AleksaHeler/OpenHand/hardware/OpenHand_v3/Datasheets/STM32_Pin_Assignment.xlsx

Pin # | Pin Name | GPIO | ADC | PWM | Misc | User Label | Notes
1 | VBAT |  |  |  | +3V3 | /
2 | PC13 |  |  |  | TAMPER-RTC |  | testpoint
3 | PC14 |  |  |  | OSC32_IN |  | testpoint
4 | PC15 |  |  |  | OSC32_OUT |  | testpoint
5 | PD0 |  |  |  | OSC_IN | XTAL_OSC_IN
6 | PD1 |  |  |  | OSC_OUT | XTAL_OSC_OUT
7 | NRST |  |  |  | NRST | RESET | NRST
8 | PC0 |  | ADC123_IN10 |  |  | EMG_01
9 | PC1 |  | ADC123_IN11 |  |  | EMG_02
10 | PC2 |  | ADC123_IN12 |  |  | TRIM_POT_01
11 | PC3 |  | ADC123_IN13 |  |  | TRIM_POT_02
12 | VSSA |  |  |  | GND | /
13 | VDDA |  |  |  | +3V3 | /
14 | PA0 |  | ADC123_IN0 | TIM2_CH1_ETR, TIM5_CH1, TIM8_ETR |  | MOTOR_03_ENCODER_A
15 | PA1 |  | ADC123_IN1 | TIM5_CH2, TIM2_CH2 |  | MOTOR_03_ENCODER_B
16 | PA2 |  | ADC123_IN2 | TIM5_CH3, TIM2_CH3 | USART2_TX |  | testpoint (ADC, TIM)
17 | PA3 |  | ADC123_IN3 | TIM5_CH4, TIM2_CH4 | USART2_RX |  | testpoint (ADC, TIM)
18 | VSS |  |  |  | GND | /
19 | VDD |  |  |  | +3V3 | /
20 | PA4 | OUTPUT | ADC12_IN4 |  |  | LED_01
21 | PA5 | OUTPUT | ADC12_IN5 |  | SPI1_SCK | LED_02
22 | PA6 |  | ADC12_IN6 | TIM8_BKIN, TIM3_CH1, TIM1_BKIN | SPI1_MISO | MOTOR_01_ENCODER_A
23 | PA7 |  | ADC12_IN7 | TIM8_CH1N, TIM3_CH2, TIM1_CH1N | SPI1_MOSI | MOTOR_01_ENCODER_B
24 | PC4 |  | ADC12_IN14 |  |  | PCB_TEMP_01
25 | PC5 |  | ADC12_IN15 |  |  | PCB_TEMP_02
26 | PB0 |  | ADC12_IN8 | TIM3_CH3, TIM8_CH2N, TIM1_CH2N |  | BATT_SENSE
27 | PB1 |  | ADC12_IN9 | TIM3_CH4, TIM8_CH3N, TIM1_CH3N |  | VIN_5V_SENSE
28 | PB2 | OUTPUT |  |  |  | MOTOR_01_EN
29 | PB10 | OUTPUT |  | TIM2_CH3 | I2C2_SCL, USART3_TX | MOTOR_02_EN
30 | PB11 | OUTPUT |  | TIM2_CH4 | I2C2_SDA, USART3_RX | MOTOR_03_EN
31 | VSS |  |  |  | GND | /
32 | VDD |  |  |  | +3V3 | /
33 | PB12 | OUTPUT |  | TIM1_BKIN |  | HAPTIC_DIR
34 | PB13 | OUTPUT |  | TIM1_CH1N | SPI2_SCK | MOTOR_01_DIR
35 | PB14 | OUTPUT |  | TIM1_CH2N | SPI2_MISO | MOTOR_02_DIR
36 | PB15 | OUTPUT |  | TIM1_CH3N | SPI2_MOSI | MOTOR_03_DIR
37 | PC6 |  |  | TIM8_CH1, TIM3_CH1 |  | HAPTIC_PWM
38 | PC7 |  |  | TIM8_CH2, TIM3_CH2 |  | MOTOR_01_PWM
39 | PC8 |  |  | TIM8_CH3, TIM3_CH3 |  | MOTOR_02_PWM
40 | PC9 |  |  | TIM8_CH4, TIM3_CH4 |  | MOTOR_03_PWM
41 | PA8 | INPUT |  | TIM1_CH1 |  | MOTOR_01_FAULT
42 | PA9 | INPUT |  | TIM1_CH2 | USART1_TX | MOTOR_02_FAULT
43 | PA10 | INPUT |  | TIM1_CH3 | USART1_RX | MOTOR_03_FAULT
44 | PA11 |  |  | TIM1_CH4 | USBDM, CAN_RX | USB-
45 | PA12 |  |  | TIM1_ETR | USBDP, CAN_TX | USB+
46 | PA13 |  |  |  | JTMS, SWDIO | SWDIO
47 | VSS |  |  |  | GND | /
48 | VDD |  |  |  | +3V3 | /
49 | PA14 |  |  |  | JTCK, SWCLK | SWCLK
50 | PA15 | INPUT |  | TIM2_CH1_ETR |  | BTN
51 | PC10 |  |  |  | UART4_TX | UART_TX
52 | PC11 |  |  |  | UART4_RX | UART_RX
53 | PC12 | OUTPUT |  |  | UART5_TX | HAPTIC_EN
54 | PD2 | INPUT |  | TIM3_ETR | UART5_RX | HAPTIC_FAULT
55 | PB3 |  |  | TIM2_CH2 | SPI3_SCK, SPI1_SCK |  | testpoint (SPI, TIM)
56 | PB4 |  |  | TIM3_CH1 | SPI3_MISO, SPI1_MISO |  | testpoint (SPI)
57 | PB5 |  |  | TIM3_CH2 | SPI3_MOSI, SPI1_MOSI |  | testpoint (SPI)
58 | PB6 |  |  | TIM4_CH1 | I2C1_SCL, USART1_TX | MOTOR_02_ENCODER_A
59 | PB7 |  |  | TIM4_CH2 | I2C1_SDA, USART1_RX | MOTOR_02_ENCODER_B
60 | PB2 |  |  |  | BOOT0 | BOOT | BOOT
61 | PB8 |  |  | TIM4_CH3 | I2C1_SCL | I2C_SCL
62 | PB9 |  |  | TIM4_CH4 | I2C1_SDA | I2C_SDA
63 | VSS |  |  |  | GND | /
64 | VDD |  |  |  | +3V3 | /
