AleksaHeler/OpenHand/hardware/OpenHand_v3/OpenHand_v3.kicad_pcb

## KiCad design hardware/OpenHand_v3/OpenHand_v3.kicad_pcb (2025-04-18)

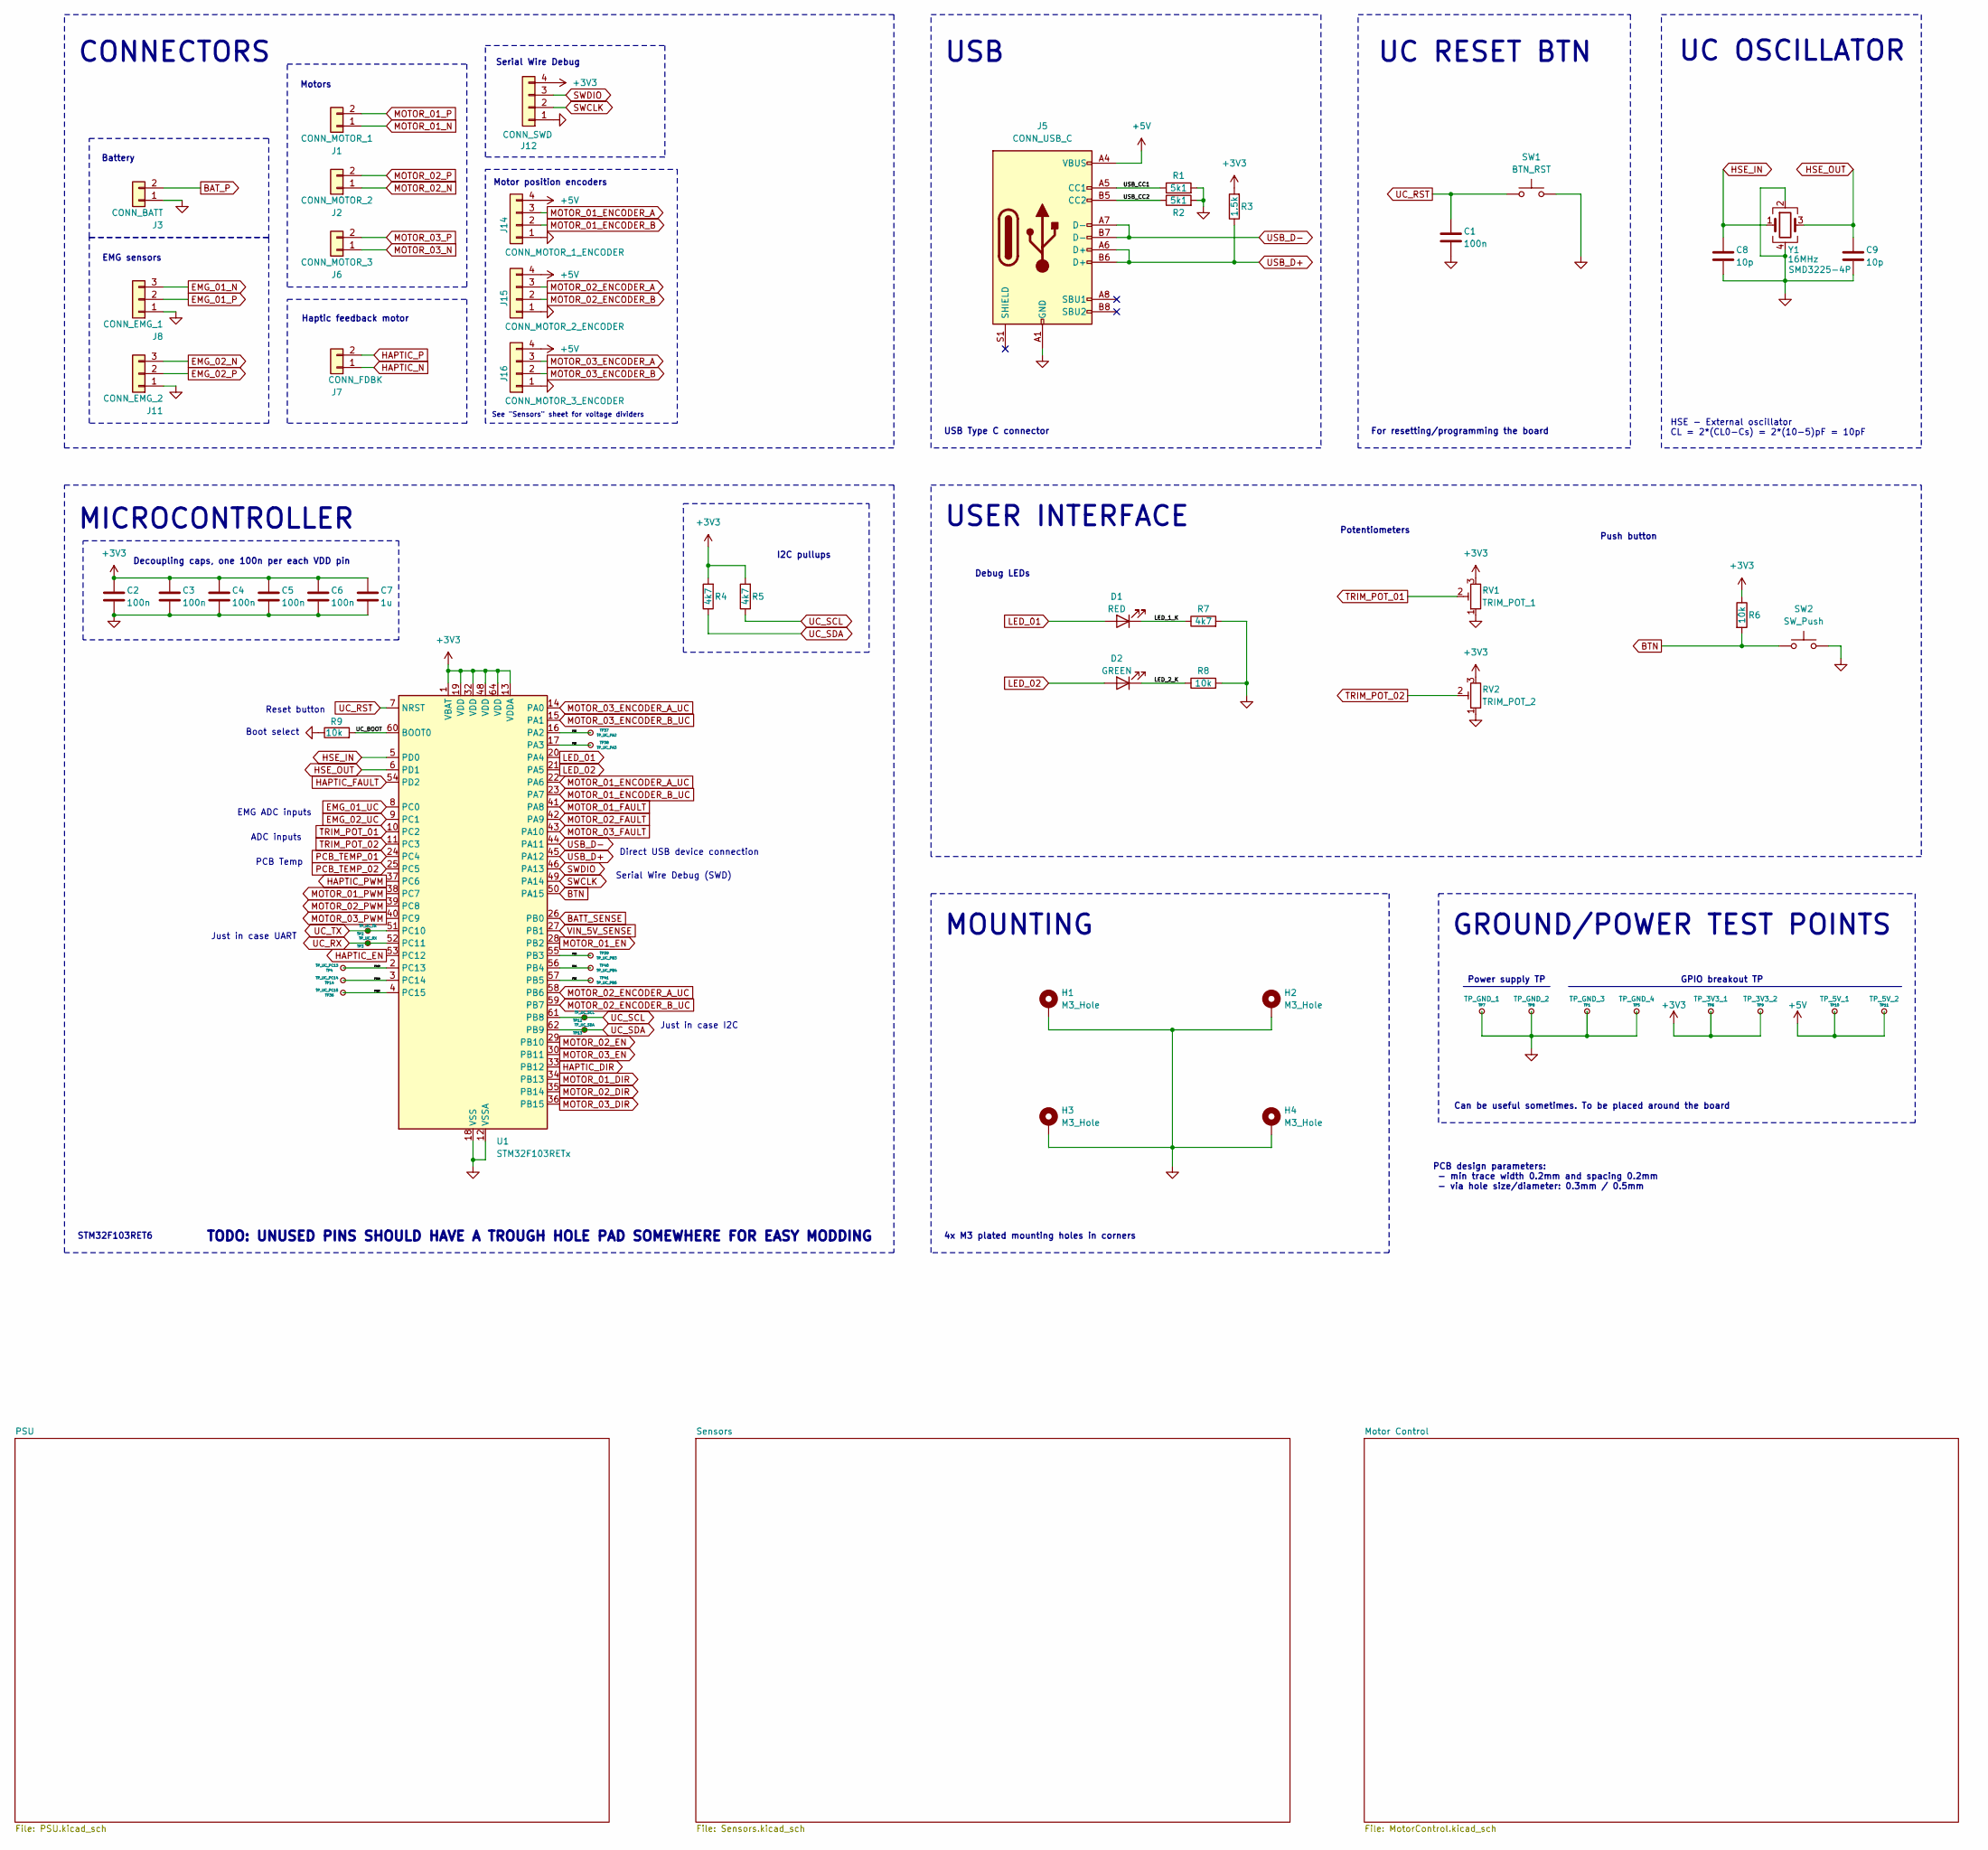
[picture p1: schematic OpenHand_v3.kicad_sch, OpenHand prosthetic hand controller project]

Parts:
C1, C2, C3, C4, C5, C6: 100n; C_0805_2012Metric
C7: 1u; C_0805_2012Metric
C8, C9: 10p; C_0805_2012Metric
D1: RED; LED_1210_3225Metric
D2: GREEN; LED_1210_3225Metric
H1, H2, H3, H4: M3_Hole; MountingHole_3.2mm_M3_Pad_Via
J1: CONN_MOTOR_1; JST_EH_S2B-EH_1x02_P2.50mm_Horizontal
J2: CONN_MOTOR_2; JST_EH_S2B-EH_1x02_P2.50mm_Horizontal
J3: CONN_BATT; JST_EH_S2B-EH_1x02_P2.50mm_Horizontal
J5: CONN_USB_C; USB_C_Receptacle_G-Switch_GT-USB-7010ASV
J6: CONN_MOTOR_3; JST_EH_S2B-EH_1x02_P2.50mm_Horizontal
J7: CONN_FDBK; JST_EH_S2B-EH_1x02_P2.50mm_Horizontal
J8: CONN_EMG_1; JST_XH_B3B-XH-A_1x03_P2.50mm_Vertical
J11: CONN_EMG_2; JST_XH_B3B-XH-A_1x03_P2.50mm_Vertical
J12: CONN_SWD; JST_XH_B4B-XH-A_1x04_P2.50mm_Vertical
J14: CONN_MOTOR_1_ENCODER; JST_XH_B4B-XH-A_1x04_P2.50mm_Vertical
J15: CONN_MOTOR_2_ENCODER; JST_XH_B4B-XH-A_1x04_P2.50mm_Vertical
J16: CONN_MOTOR_3_ENCODER; JST_XH_B4B-XH-A_1x04_P2.50mm_Vertical
R1, R2: 5k1; R_0805_2012Metric
R3: 1.5k; R_0805_2012Metric
R4, R5, R7: 4k7; R_0805_2012Metric
R6, R8, R9: 10k; R_0805_2012Metric
RV1: TRIM_POT_1; Potentiometer_Vishay_TS53YJ_Vertical
RV2: TRIM_POT_2; Potentiometer_Vishay_TS53YJ_Vertical
SW1: BTN_RST; SW_Tactile_SPST_NO_Straight_CK_PTS636Sx25SMTRLFS
SW2: SW_Push; SW_Tactile_SPST_NO_Straight_CK_PTS636Sx25SMTRLFS
TP1: TP_GND_3; TestPoint_THTPad_D1.5mm_Drill0.7mm
TP2: TP_UC_TX; TestPoint_THTPad_D1.5mm_Drill0.7mm
TP3: TP_UC_RX; TestPoint_THTPad_D1.5mm_Drill0.7mm
TP4: TP_UC_PC13; TestPoint_THTPad_D1.5mm_Drill0.7mm
TP5: TP_GND_4; TestPoint_THTPad_D1.5mm_Drill0.7mm
TP6: TP_3V3_1; TestPoint_THTPad_D1.5mm_Drill0.7mm
TP7: TP_GND_1; TestPoint_THTPad_D1.5mm_Drill0.7mm
TP8: TP_GND_2; TestPoint_THTPad_D1.5mm_Drill0.7mm
TP9: TP_3V3_2; TestPoint_THTPad_D1.5mm_Drill0.7mm
TP10: TP_5V_1; TestPoint_THTPad_D1.5mm_Drill0.7mm
TP11: TP_5V_2; TestPoint_THTPad_D1.5mm_Drill0.7mm
TP12: TP_UC_SCL; TestPoint_THTPad_D1.5mm_Drill0.7mm
TP13: TP_UC_SDA; TestPoint_THTPad_D1.5mm_Drill0.7mm
TP14: TP_UC_PC14; TestPoint_THTPad_D1.5mm_Drill0.7mm
TP36: TP_UC_PC15; TestPoint_THTPad_D1.5mm_Drill0.7mm
TP37: TP_UC_PA2; TestPoint_THTPad_D1.5mm_Drill0.7mm
TP38: TP_UC_PA3; TestPoint_THTPad_D1.5mm_Drill0.7mm
TP39: TP_UC_PB3; TestPoint_THTPad_D1.5mm_Drill0.7mm
TP40: TP_UC_PB4; TestPoint_THTPad_D1.5mm_Drill0.7mm
TP41: TP_UC_PB5; TestPoint_THTPad_D1.5mm_Drill0.7mm
U1: STM32F103RETx; LQFP-64_10x10mm_P0.5mm
Y1: 16MHz; Crystal_SMD_3225-4Pin_3.2x2.5mm

Connections:
+3V3: C2.1, C3.1, C4.1, C5.1, C6.1, C7.1, J12.4, R3.2, R4.2, R5.2, R6.1, RV1.3, RV2.3, TP6.1, TP9.1, U1.1 (VBAT), U1.13 (VDDA), U1.19 (VDD), U1.32 (VDD), U1.48 (VDD), U1.64 (VDD); also elsewhere on the board
+5V: J5.A4 (VBUS), J5.A9 (VBUS), J5.B4 (VBUS), J5.B9 (VBUS), J14.4, J15.4, J16.4, TP10.1, TP11.1; also elsewhere on the board
/LED_1_K: D1.1 (K), R7.1
/LED_2_K: D2.1 (K), R8.1
/PA2: TP37.1, U1.16 (PA2)
/PA3: TP38.1, U1.17 (PA3)
/PB3: TP39.1, U1.55 (PB3)
/PB4: TP40.1, U1.56 (PB4)
/PB5: TP41.1, U1.57 (PB5)
/PC13: TP4.1, U1.2 (PC13)
/PC14: TP14.1, U1.3 (PC14)
/PC15: TP36.1, U1.4 (PC15)
/UC_BOOT: R9.2, U1.60 (BOOT0)
/USB_CC1: J5.A5 (CC1), R1.1
/USB_CC2: J5.B5 (CC2), R2.1
BATT_SENSE: U1.26 (PB0); also elsewhere on the board
BAT_P: J3.2; also elsewhere on the board
BTN: R6.2, SW2.1, U1.50 (PA15)
EMG_01_N: J8.3; also elsewhere on the board
EMG_01_P: J8.2; also elsewhere on the board
EMG_01_UC: U1.8 (PC0); also elsewhere on the board
EMG_02_N: J11.3; also elsewhere on the board
EMG_02_P: J11.2; also elsewhere on the board
EMG_02_UC: U1.9 (PC1); also elsewhere on the board
GND: C1.2, C2.2, C3.2, C4.2, C5.2, C6.2, C7.2, C8.2, C9.2, H1.1, H2.1, H3.1, H4.1, J3.1, J5.A1 (GND), J5.A12 (GND), J5.B1 (GND), J5.B12 (GND), J8.1, J11.1, J12.1, J14.1, J15.1, J16.1, R1.2, R2.2, R7.2, R8.2, R9.1, RV1.1, RV2.1, SW1.2, SW2.2, TP1.1, TP5.1, TP7.1, TP8.1, U1.12 (VSSA), U1.18 (VSS), U1.31 (VSS), U1.47 (VSS), U1.63 (VSS), Y1.2, Y1.4; also elsewhere on the board
HAPTIC_DIR: U1.33 (PB12); also elsewhere on the board
HAPTIC_EN: U1.53 (PC12); also elsewhere on the board
HAPTIC_FAULT: U1.54 (PD2); also elsewhere on the board
HAPTIC_N: J7.1; also elsewhere on the board
HAPTIC_P: J7.2; also elsewhere on the board
HAPTIC_PWM: U1.37 (PC6); also elsewhere on the board
HSE_IN: C8.1, U1.5 (PD0), Y1.1
HSE_OUT: C9.1, U1.6 (PD1), Y1.3
LED_01: D1.2 (A), U1.20 (PA4)
LED_02: D2.2 (A), U1.21 (PA5)
MOTOR_01_DIR: U1.34 (PB13); also elsewhere on the board
MOTOR_01_EN: U1.28 (PB2); also elsewhere on the board
MOTOR_01_ENCODER_A: J14.3; also elsewhere on the board
MOTOR_01_ENCODER_A_UC: U1.22 (PA6); also elsewhere on the board
MOTOR_01_ENCODER_B: J14.2; also elsewhere on the board
MOTOR_01_ENCODER_B_UC: U1.23 (PA7); also elsewhere on the board
MOTOR_01_FAULT: U1.41 (PA8); also elsewhere on the board
MOTOR_01_N: J1.1; also elsewhere on the board
MOTOR_01_P: J1.2; also elsewhere on the board
MOTOR_01_PWM: U1.38 (PC7); also elsewhere on the board
MOTOR_02_DIR: U1.35 (PB14); also elsewhere on the board
MOTOR_02_EN: U1.29 (PB10); also elsewhere on the board
MOTOR_02_ENCODER_A: J15.3; also elsewhere on the board
MOTOR_02_ENCODER_A_UC: U1.58 (PB6); also elsewhere on the board
MOTOR_02_ENCODER_B: J15.2; also elsewhere on the board
MOTOR_02_ENCODER_B_UC: U1.59 (PB7); also elsewhere on the board
MOTOR_02_FAULT: U1.42 (PA9); also elsewhere on the board
MOTOR_02_N: J2.1; also elsewhere on the board
MOTOR_02_P: J2.2; also elsewhere on the board
MOTOR_02_PWM: U1.39 (PC8); also elsewhere on the board
MOTOR_03_DIR: U1.36 (PB15); also elsewhere on the board
MOTOR_03_EN: U1.30 (PB11); also elsewhere on the board
MOTOR_03_ENCODER_A: J16.3; also elsewhere on the board
MOTOR_03_ENCODER_A_UC: U1.14 (PA0); also elsewhere on the board
MOTOR_03_ENCODER_B: J16.2; also elsewhere on the board
MOTOR_03_ENCODER_B_UC: U1.15 (PA1); also elsewhere on the board
MOTOR_03_FAULT: U1.43 (PA10); also elsewhere on the board
MOTOR_03_N: J6.1; also elsewhere on the board
MOTOR_03_P: J6.2; also elsewhere on the board
MOTOR_03_PWM: U1.40 (PC9); also elsewhere on the board
PCB_TEMP_01: U1.24 (PC4); also elsewhere on the board
PCB_TEMP_02: U1.25 (PC5); also elsewhere on the board
SWCLK: J12.2, U1.49 (PA14)
SWDIO: J12.3, U1.46 (PA13)
TRIM_POT_01: RV1.2, U1.10 (PC2)
TRIM_POT_02: RV2.2, U1.11 (PC3)
UC_RST: C1.1, SW1.1, U1.7 (NRST)
UC_RX: TP3.1, U1.52 (PC11)
UC_SCL: R5.1, TP12.1, U1.61 (PB8)
UC_SDA: R4.1, TP13.1, U1.62 (PB9)
UC_TX: TP2.1, U1.51 (PC10)
USB_D+: J5.A6 (D+), J5.B6 (D+), R3.1, U1.45 (PA12)
USB_D-: J5.A7 (D-), J5.B7 (D-), U1.44 (PA11)
VIN_5V_SENSE: U1.27 (PB1); also elsewhere on the board

Notes on the sheet:
I2C pullups
Debug LEDs
UC RESET BTN
Potentiometers
ADC inputs
Serial Wire Debug (SWD)
MICROCONTROLLER
Battery
PCB Temp
Haptic feedback motor
Reset button
Just in case I2C
USB
Push button
4x M3 plated mounting holes in corners
TODO: UNUSED PINS SHOULD HAVE A TROUGH HOLE PAD SOMEWHERE FOR EASY MODDING
Power supply TP
Motors
MOUNTING
CONNECTORS
PCB design parameters: - min trace width 0.2mm and spacing 0.2mm - via hole size/diameter: 0.3mm / 0.5mm
EMG ADC inputs
For resetting/programming the board
Can be useful sometimes. To be placed around the board
USB Type C connector
Decoupling caps, one 100n per each VDD pin
USER INTERFACE
STM32F103RET6
GROUND/POWER TEST POINTS
Boot select
GPIO breakout TP
EMG sensors
Direct USB device connection
HSE - External oscillator CL = 2*(CL0-Cs) = 2*(10-5)pF = 10pF
See "Sensors" sheet for voltage dividers
UC OSCILLATOR
Just in case UART
Serial Wire Debug
Motor position encoders

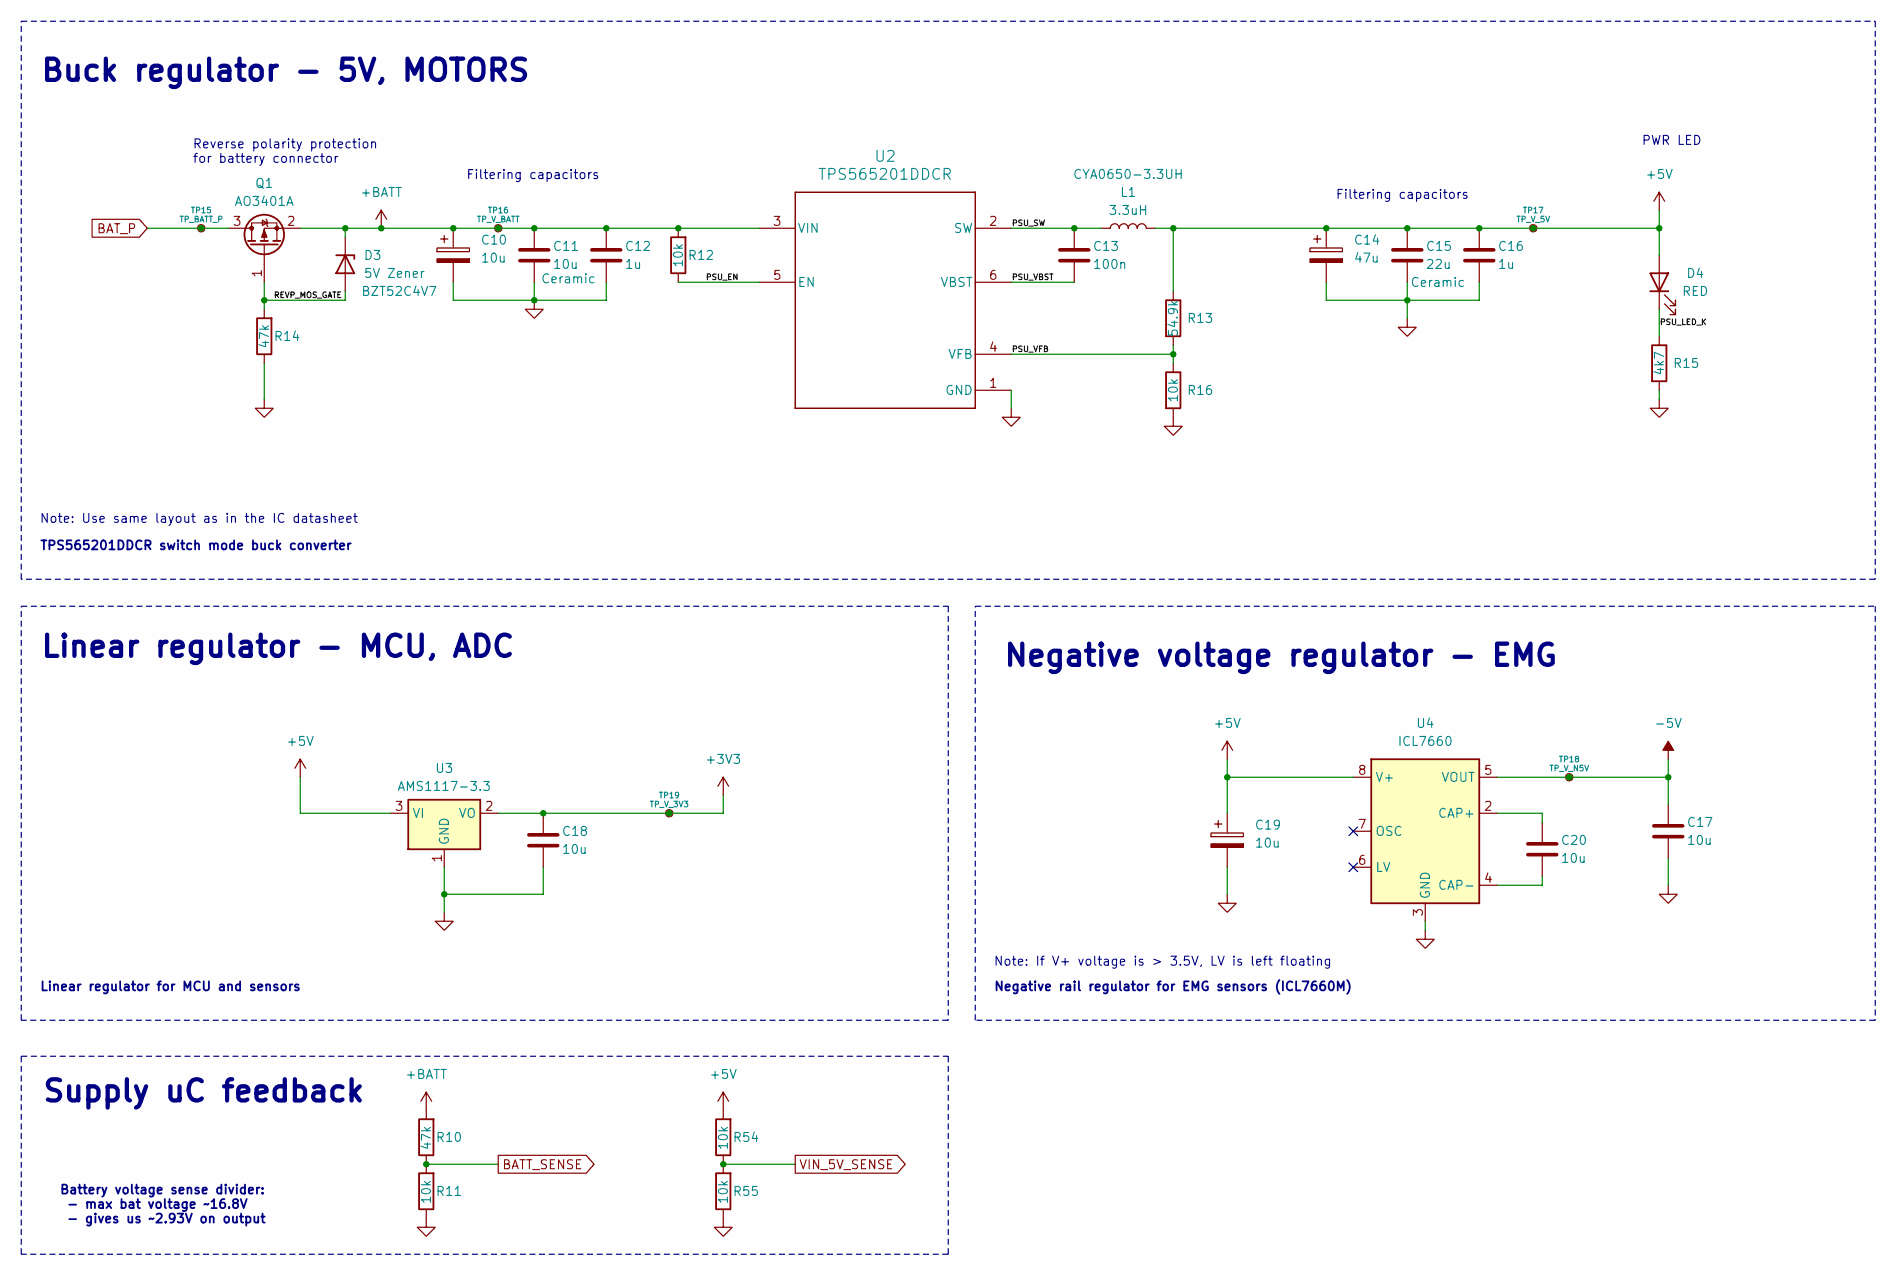
[picture p2: schematic PSU.kicad_sch, OpenHand prosthetic hand controller project]

Parts:
C10, C19: 10u; CP_Elec_4x5.4
C11, C17, C18, C20: 10u; C_0805_2012Metric
C12, C16: 1u; C_0805_2012Metric
C13: 100n; C_0805_2012Metric
C14: 47u; CP_Elec_6.3x5.4
C15: 22u; C_0805_2012Metric
D3: 5V Zener; D_SOD-123; Part Number BZT52C4V7
D4: RED; LED_1210_3225Metric
L1: 3.3uH; L_Bourns_SRP7028A_7.3x6.6mm; Part Number CYA0650-3.3UH
Q1: AO3401A; SOT-23
R10, R14: 47k; R_0805_2012Metric
R11, R12, R16, R54, R55: 10k; R_0805_2012Metric
R13: 54.9k; R_0805_2012Metric
R15: 4k7; R_0805_2012Metric
TP15: TP_BATT_P; TestPoint_Pad_D1.0mm
TP16: TP_V_BATT; TestPoint_Pad_D1.0mm
TP17: TP_V_5V; TestPoint_THTPad_D1.5mm_Drill0.7mm
TP18: TP_V_N5V; TestPoint_THTPad_D1.5mm_Drill0.7mm
TP19: TP_V_3V3; TestPoint_THTPad_D1.5mm_Drill0.7mm
U2: TPS565201DDCR; TPS565201DDCR_L
U3: AMS1117-3.3; SOT-223-3_TabPin2
U4: ICL7660; SOP-8_3.9x4.9mm_P1.27mm

Connections:
+3V3: C18.1, TP19.1, U3.2 (VO); also elsewhere on the board
+5V: C14.1, C15.1, C16.1, C19.1, D4.2 (A), L1.2, R13.1, R54.2, TP17.1, U3.3 (VI), U4.8 (V+); also elsewhere on the board
+BATT: C10.1, C11.1, C12.1, D3.1 (K), Q1.2 (S), R10.2, R12.2, TP16.1, U2.3 (VIN)
-5V: C17.1, TP18.1, U4.5 (VOUT); also elsewhere on the board
/PSU/PSU_EN: R12.1, U2.5 (EN)
/PSU/PSU_LED_K: D4.1 (K), R15.1
/PSU/PSU_SW: C13.1, L1.1, U2.2 (SW)
/PSU/PSU_VBST: C13.2, U2.6 (VBST)
/PSU/PSU_VFB: R13.2, R16.1, U2.4 (VFB)
/PSU/REVP_MOS_GATE: D3.2 (A), Q1.1 (G), R14.2
BATT_SENSE: R10.1, R11.2; also elsewhere on the board
BAT_P: Q1.3 (D), TP15.1; also elsewhere on the board
GND: C10.2, C11.2, C12.2, C14.2, C15.2, C16.2, C17.2, C18.2, C19.2, R11.1, R14.1, R15.2, R16.2, R55.1, U2.1 (GND), U3.1 (GND), U4.3 (GND); also elsewhere on the board
unnamed: C20.1, U4.2 (CAP+)
unnamed: C20.2, U4.4 (CAP-)
VIN_5V_SENSE: R54.1, R55.2; also elsewhere on the board

Notes on the sheet:
Linear regulator - MCU, ADC
Note: Use same layout as in the IC datasheet
Filtering capacitors
Supply uC feedback
PWR LED
Note: If V+ voltage is > 3.5V, LV is left floating
Negative voltage regulator - EMG
Buck regulator - 5V, MOTORS
TPS565201DDCR switch mode buck converter
Battery voltage sense divider: - max bat voltage ~16.8V - gives us ~2.93V on output
Negative rail regulator for EMG sensors (ICL7660M)
Linear regulator for MCU and sensors
Reverse polarity protection for battery connector

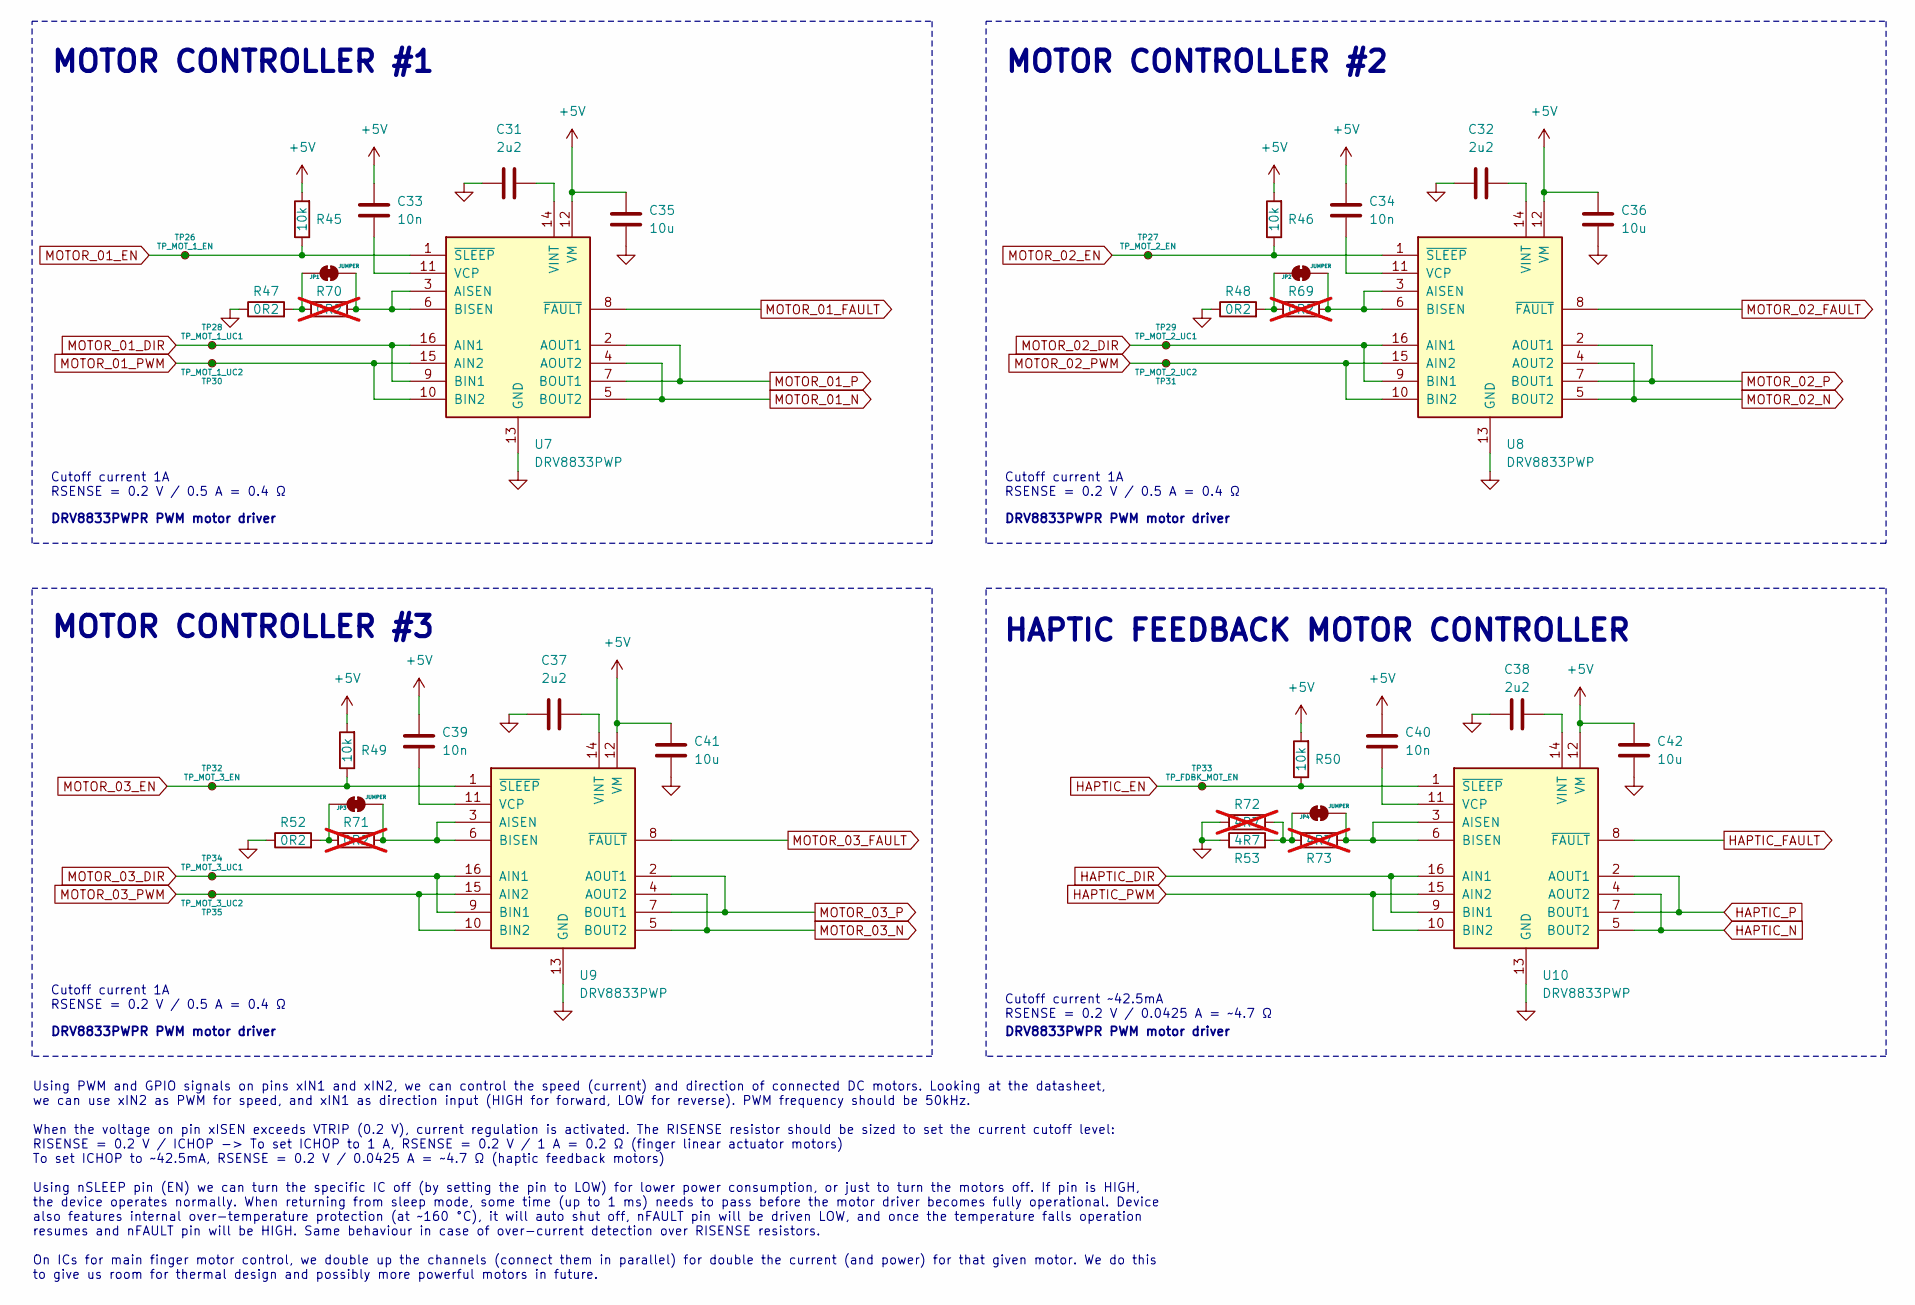
[picture p3: schematic MotorControl.kicad_sch, OpenHand prosthetic hand controller project]

Parts:
C31, C32, C37, C38: 2u2; C_0805_2012Metric
C33, C34, C39, C40: 10n; C_0805_2012Metric
C35, C36, C41, C42: 10u; C_0805_2012Metric
JP1, JP2, JP3, JP4: JUMPER; SolderJumper-2_P1.3mm_Bridged_RoundedPad1.0x1.5mm
R45, R46, R49, R50: 10k; R_0805_2012Metric
R47, R48, R52: 0R2; R_1206_3216Metric
R53: 4R7; R_1206_3216Metric
R69, R70, R71: 0R2; R_1206_3216Metric; not fitted
R72, R73: 4R7; R_1206_3216Metric; not fitted
TP26: TP_MOT_1_EN; TestPoint_Pad_D1.0mm
TP27: TP_MOT_2_EN; TestPoint_Pad_D1.0mm
TP28: TP_MOT_1_UC1; TestPoint_Pad_D1.0mm
TP29: TP_MOT_2_UC1; TestPoint_Pad_D1.0mm
TP30: TP_MOT_1_UC2; TestPoint_Pad_D1.0mm
TP31: TP_MOT_2_UC2; TestPoint_Pad_D1.0mm
TP32: TP_MOT_3_EN; TestPoint_Pad_D1.0mm
TP33: TP_FDBK_MOT_EN; TestPoint_Pad_D1.0mm
TP34: TP_MOT_3_UC1; TestPoint_Pad_D1.0mm
TP35: TP_MOT_3_UC2; TestPoint_Pad_D1.0mm
U7, U8, U9, U10: DRV8833PWP; HTSSOP-16-1EP_4.4x5mm_P0.65mm_EP3.4x5mm_Mask2.46x2.31mm_The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

Connections:
+5V: C33.1, C34.1, C35.1, C36.1, C39.1, C40.1, C41.1, C42.1, R45.2, R46.2, R49.2, R50.2, U7.12 (VM), U8.12 (VM), U9.12 (VM), U10.12 (VM); also elsewhere on the board
GND: C31.1, C32.1, C35.2, C36.2, C37.1, C38.1, C41.2, C42.2, R47.1, R48.1, R52.1, R53.1, R72.2, U7.13 (GND), U7.17 (GND), U8.13 (GND), U8.17 (GND), U9.13 (GND), U9.17 (GND), U10.13 (GND), U10.17 (GND); also elsewhere on the board
HAPTIC_DIR: U10.9 (BIN1), U10.16 (AIN1); also elsewhere on the board
HAPTIC_EN: R50.1, TP33.1, U10.1 (~SLEEP); also elsewhere on the board
HAPTIC_FAULT: U10.8 (~FAULT); also elsewhere on the board
HAPTIC_N: U10.4 (AOUT2), U10.5 (BOUT2); also elsewhere on the board
HAPTIC_P: U10.2 (AOUT1), U10.7 (BOUT1); also elsewhere on the board
HAPTIC_PWM: U10.10 (BIN2), U10.15 (AIN2); also elsewhere on the board
MOTOR_01_DIR: TP28.1, U7.9 (BIN1), U7.16 (AIN1); also elsewhere on the board
MOTOR_01_EN: R45.1, TP26.1, U7.1 (~SLEEP); also elsewhere on the board
MOTOR_01_FAULT: U7.8 (~FAULT); also elsewhere on the board
MOTOR_01_N: U7.4 (AOUT2), U7.5 (BOUT2); also elsewhere on the board
MOTOR_01_P: U7.2 (AOUT1), U7.7 (BOUT1); also elsewhere on the board
MOTOR_01_PWM: TP30.1, U7.10 (BIN2), U7.15 (AIN2); also elsewhere on the board
MOTOR_02_DIR: TP29.1, U8.9 (BIN1), U8.16 (AIN1); also elsewhere on the board
MOTOR_02_EN: R46.1, TP27.1, U8.1 (~SLEEP); also elsewhere on the board
MOTOR_02_FAULT: U8.8 (~FAULT); also elsewhere on the board
MOTOR_02_N: U8.4 (AOUT2), U8.5 (BOUT2); also elsewhere on the board
MOTOR_02_P: U8.2 (AOUT1), U8.7 (BOUT1); also elsewhere on the board
MOTOR_02_PWM: TP31.1, U8.10 (BIN2), U8.15 (AIN2); also elsewhere on the board
MOTOR_03_DIR: TP34.1, U9.9 (BIN1), U9.16 (AIN1); also elsewhere on the board
MOTOR_03_EN: R49.1, TP32.1, U9.1 (~SLEEP); also elsewhere on the board
MOTOR_03_FAULT: U9.8 (~FAULT); also elsewhere on the board
MOTOR_03_N: U9.4 (AOUT2), U9.5 (BOUT2); also elsewhere on the board
MOTOR_03_P: U9.2 (AOUT1), U9.7 (BOUT1); also elsewhere on the board
MOTOR_03_PWM: TP35.1, U9.10 (BIN2), U9.15 (AIN2); also elsewhere on the board
unnamed: JP1.1 (A), R47.2, R70.1
unnamed: JP1.2 (B), R70.2, U7.3 (AISEN), U7.6 (BISEN)
unnamed: JP2.1 (A), R48.2, R69.1
unnamed: JP2.2 (B), R69.2, U8.3 (AISEN), U8.6 (BISEN)
unnamed: JP3.1 (A), R52.2, R71.1
unnamed: JP3.2 (B), R71.2, U9.3 (AISEN), U9.6 (BISEN)
unnamed: JP4.1 (A), R53.2, R72.1, R73.1
unnamed: JP4.2 (B), R73.2, U10.3 (AISEN), U10.6 (BISEN)
unnamed: C33.2, U7.11 (VCP)
unnamed: C31.2, U7.14 (VINT)
unnamed: C34.2, U8.11 (VCP)
unnamed: C32.2, U8.14 (VINT)
unnamed: C39.2, U9.11 (VCP)
unnamed: C37.2, U9.14 (VINT)
unnamed: C40.2, U10.11 (VCP)
unnamed: C38.2, U10.14 (VINT)

Notes on the sheet:
Cutoff current 1A RSENSE = 0.2 V / 0.5 A = 0.4 Ω
MOTOR CONTROLLER #1
DRV8833PWPR PWM motor driver
HAPTIC FEEDBACK MOTOR CONTROLLER
Using PWM and GPIO signals on pins xIN1 and xIN2, we can control the speed (current) and direction of connected DC motors. Looking at the datasheet, we can use xIN2 as PWM for speed, and xIN1 as direction input (HIGH for forward, LOW for reverse). PWM frequency should be 50kHz. When the voltage on 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
MOTOR CONTROLLER #3
MOTOR CONTROLLER #2
Cutoff current ~42.5mA RSENSE = 0.2 V / 0.0425 A = ~4.7 Ω
Cutoff current 1A RSENSE = 0.2 V / 0.5 A = 0.4 Ω

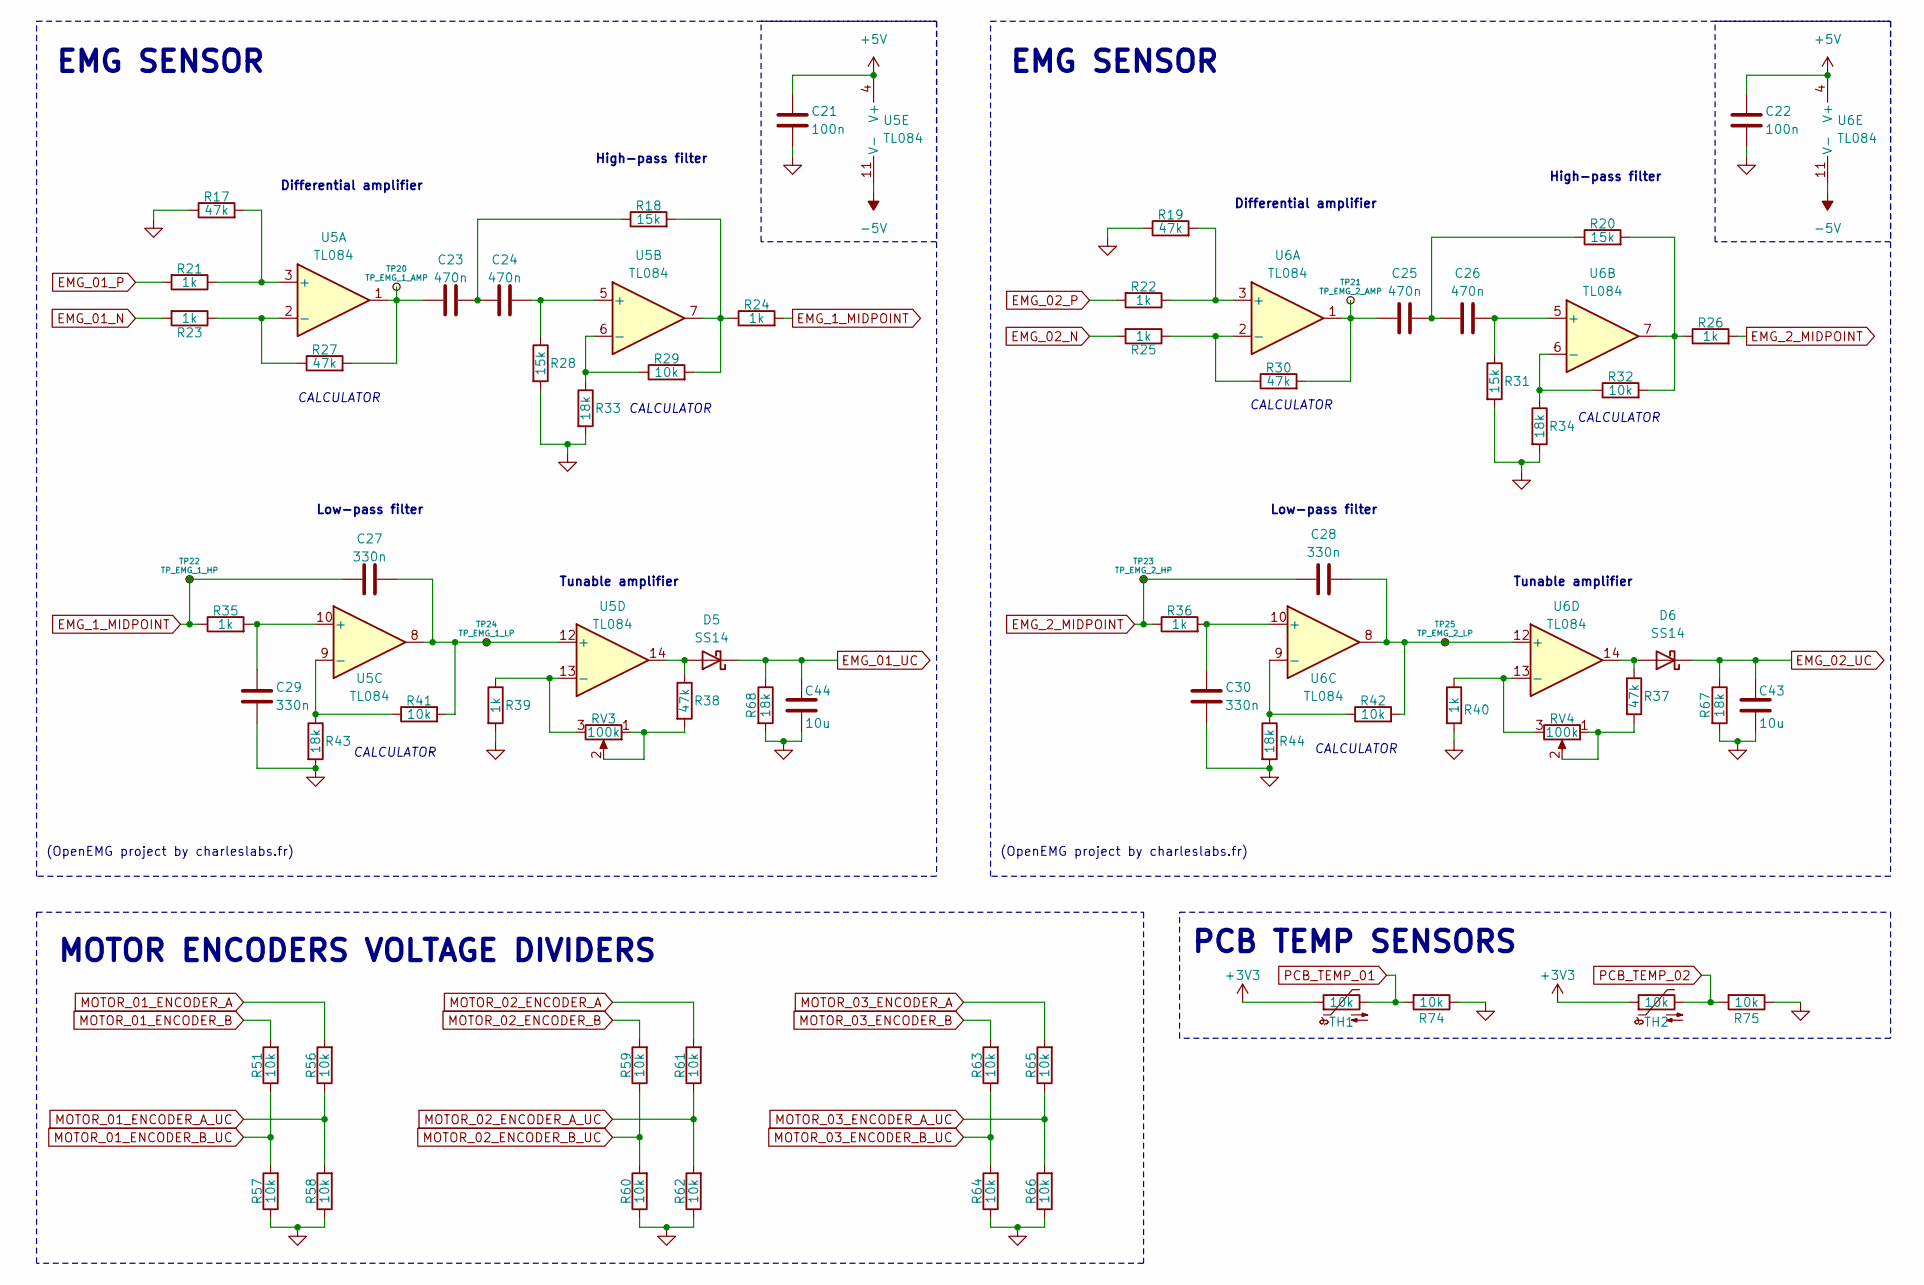
[picture p4: schematic Sensors.kicad_sch, OpenHand prosthetic hand controller project]

Parts:
C21, C22: 100n; C_0805_2012Metric
C23, C24, C25, C26: 470n; C_0805_2012Metric
C27, C28, C29, C30: 330n; C_0805_2012Metric
C43, C44: 10u; C_0805_2012Metric
D5, D6: SS14; D_SOD-123
R17, R19, R27, R30, R37, R38: 47k; R_0805_2012Metric
R18, R20, R28, R31: 15k; R_0805_2012Metric
R21, R22, R23, R24, R25, R26, R35, R36, R39, R40: 1k; R_0805_2012Metric
R29, R32, R41, R42, R51, R56, R57, R58, R59, R60, R61, R62, R63, R64, R65, R66, R74, R75: 10k; R_0805_2012Metric
R33, R34, R43, R44, R67, R68: 18k; R_0805_2012Metric
RV3, RV4: 100k; Potentiometer_Vishay_TS53YJ_Vertical
TH1, TH2: 10k; R_0805_2012Metric
TP20: TP_EMG_1_AMP; TestPoint_Pad_D1.0mm
TP21: TP_EMG_2_AMP; TestPoint_Pad_D1.0mm
TP22: TP_EMG_1_HP; TestPoint_Pad_D1.0mm
TP23: TP_EMG_2_HP; TestPoint_Pad_D1.0mm
TP24: TP_EMG_1_LP; TestPoint_Pad_D1.0mm
TP25: TP_EMG_2_LP; TestPoint_Pad_D1.0mm
U5, U6: TL084; SO-14_5.3x10.2mm_P1.27mm

Connections:
+3V3: TH1.1, TH2.1; also elsewhere on the board
+5V: C21.1, C22.1, U5.4 (V+), U6.4 (V+); also elsewhere on the board
-5V: U5.11 (V-), U6.11 (V-); also elsewhere on the board
EMG_1_MIDPOINT: C27.1, R24.2, R35.1, TP22.1
EMG_01_N: R23.2; also elsewhere on the board
EMG_01_P: R21.2; also elsewhere on the board
EMG_01_UC: C44.1, D5.1 (K), R68.1; also elsewhere on the board
EMG_2_MIDPOINT: C28.1, R26.2, R36.1, TP23.1
EMG_02_N: R25.2; also elsewhere on the board
EMG_02_P: R22.2; also elsewhere on the board
EMG_02_UC: C43.1, D6.1 (K), R67.1; also elsewhere on the board
GND: C21.2, C22.2, C29.1, C30.1, C43.2, C44.2, R17.1, R19.1, R28.2, R31.2, R33.2, R34.2, R39.2, R40.2, R43.2, R44.2, R57.1, R58.1, R60.1, R62.1, R64.1, R66.1, R67.2, R68.2, R74.1, R75.1; also elsewhere on the board
MOTOR_01_ENCODER_A: R56.2; also elsewhere on the board
MOTOR_01_ENCODER_A_UC: R56.1, R58.2; also elsewhere on the board
MOTOR_01_ENCODER_B: R51.2; also elsewhere on the board
MOTOR_01_ENCODER_B_UC: R51.1, R57.2; also elsewhere on the board
MOTOR_02_ENCODER_A: R61.2; also elsewhere on the board
MOTOR_02_ENCODER_A_UC: R61.1, R62.2; also elsewhere on the board
MOTOR_02_ENCODER_B: R59.2; also elsewhere on the board
MOTOR_02_ENCODER_B_UC: R59.1, R60.2; also elsewhere on the board
MOTOR_03_ENCODER_A: R65.2; also elsewhere on the board
MOTOR_03_ENCODER_A_UC: R65.1, R66.2; also elsewhere on the board
MOTOR_03_ENCODER_B: R63.2; also elsewhere on the board
MOTOR_03_ENCODER_B_UC: R63.1, R64.2; also elsewhere on the board
unnamed: C23.1, R27.2, TP20.1, U5.1
unnamed: C23.2, C24.1, R18.1
unnamed: C25.1, R30.2, TP21.1, U6.1
unnamed: C25.2, C26.1, R20.1
unnamed: D5.2 (A), R38.1, U5.14
unnamed: D6.2 (A), R37.1, U6.14
unnamed: R18.2, R24.1, R29.2, U5.7
unnamed: R20.2, R26.1, R32.2, U6.7
unnamed: R37.2, RV4.1, RV4.2
unnamed: R38.2, RV3.1, RV3.2
unnamed: R17.2, R21.1, U5.3 (+)
unnamed: R23.1, R27.1, U5.2 (-)
unnamed: C24.2, R28.1, U5.5 (+)
unnamed: R29.1, R33.1, U5.6 (-)
unnamed: C29.2, R35.2, U5.10 (+)
unnamed: R41.1, R43.1, U5.9 (-)
unnamed: C27.2, R41.2, TP24.1, U5.8, U5.12 (+)
unnamed: R39.1, RV3.3, U5.13 (-)
unnamed: R19.2, R22.1, U6.3 (+)
unnamed: R25.1, R30.1, U6.2 (-)
unnamed: C26.2, R31.1, U6.5 (+)
unnamed: R32.1, R34.1, U6.6 (-)
unnamed: C30.2, R36.2, U6.10 (+)
unnamed: R42.1, R44.1, U6.9 (-)
unnamed: C28.2, R42.2, TP25.1, U6.8, U6.12 (+)
unnamed: R40.1, RV4.3, U6.13 (-)
PCB_TEMP_01: R74.2, TH1.2; also elsewhere on the board
PCB_TEMP_02: R75.2, TH2.2; also elsewhere on the board

Notes on the sheet:
EMG SENSOR
MOTOR ENCODERS VOLTAGE DIVIDERS
Low-pass filter
CALCULATOR
PCB TEMP SENSORS
Differential amplifier
(OpenEMG project by charleslabs.fr)
High-pass filter
Tunable amplifier

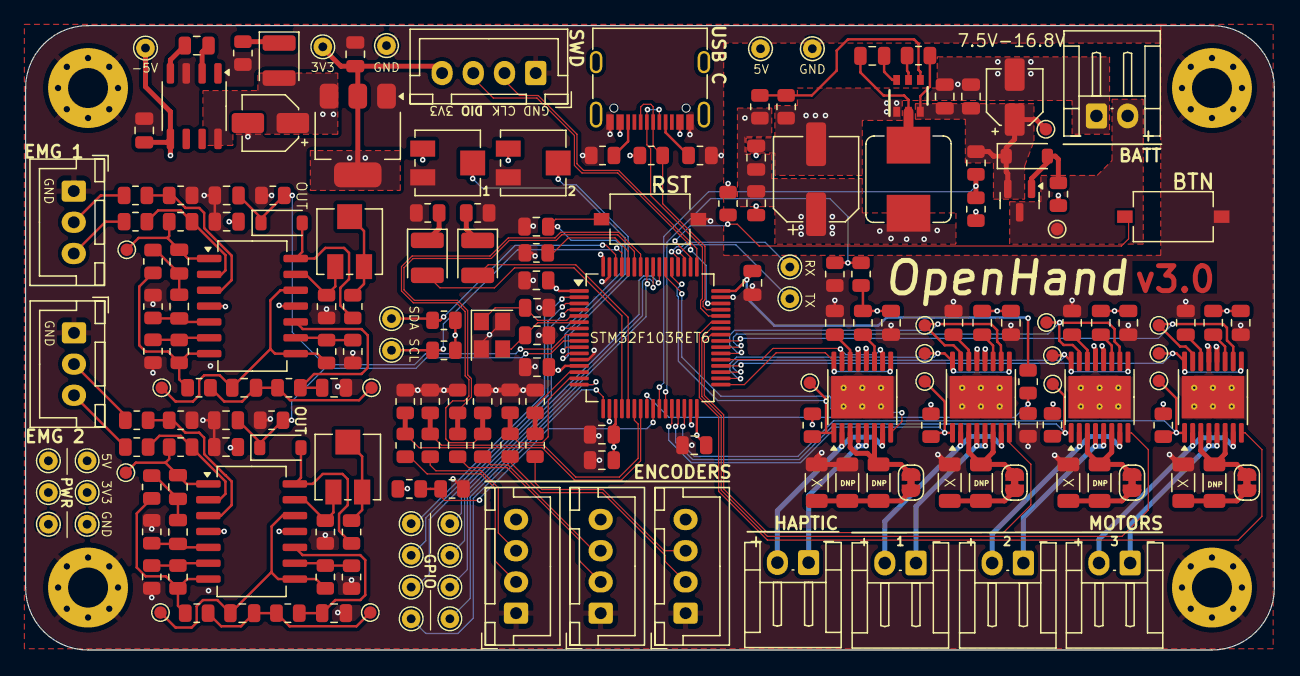
[picture p5: board OpenHand_v3.kicad_pcb from above]

Board: 4 copper layers, 100.0 x 50.0 mm, 207 parts (0 on the bottom side), 133 nets.
