AleksaHeler/OpenHand/firmware/OpenHand_STM32/OpenHandFirmware/Core/Inc/main.h

#define EMG_01_Pin GPIO_PIN_0
#define EMG_01_GPIO_Port GPIOC
#define EMG_02_Pin GPIO_PIN_1
#define EMG_02_GPIO_Port GPIOC
#define TRIM_POT_01_Pin GPIO_PIN_2
#define TRIM_POT_01_GPIO_Port GPIOC
#define TRIM_POT_02_Pin GPIO_PIN_3
#define TRIM_POT_02_GPIO_Port GPIOC
#define MOTOR_03_ENCODER_A_Pin GPIO_PIN_0
#define MOTOR_03_ENCODER_A_GPIO_Port GPIOA
#define MOTOR_03_ENCODER_B_Pin GPIO_PIN_1
#define MOTOR_03_ENCODER_B_GPIO_Port GPIOA
#define LED_01_Pin GPIO_PIN_4
#define LED_01_GPIO_Port GPIOA
#define LED_02_Pin GPIO_PIN_5
#define LED_02_GPIO_Port GPIOA
#define MOTOR_01_ENCODER_A_Pin GPIO_PIN_6
#define MOTOR_01_ENCODER_A_GPIO_Port GPIOA
#define MOTOR_01_ENCODER_B_Pin GPIO_PIN_7
#define MOTOR_01_ENCODER_B_GPIO_Port GPIOA
#define PCB_TEMP_01_Pin GPIO_PIN_4
#define PCB_TEMP_01_GPIO_Port GPIOC
#define PCB_TEMP_02_Pin GPIO_PIN_5
#define PCB_TEMP_02_GPIO_Port GPIOC
#define BATT_SENSE_Pin GPIO_PIN_0
#define BATT_SENSE_GPIO_Port GPIOB
#define VIN_5V_SENSE_Pin GPIO_PIN_1
#define VIN_5V_SENSE_GPIO_Port GPIOB
#define MOTOR_01_EN_Pin GPIO_PIN_2
#define MOTOR_01_EN_GPIO_Port GPIOB
#define MOTOR_02_EN_Pin GPIO_PIN_10
#define MOTOR_02_EN_GPIO_Port GPIOB
#define MOTOR_03_EN_Pin GPIO_PIN_11
#define MOTOR_03_EN_GPIO_Port GPIOB
#define HAPTIC_DIR_Pin GPIO_PIN_12
#define HAPTIC_DIR_GPIO_Port GPIOB
#define MOTOR_01_DIR_Pin GPIO_PIN_13
#define MOTOR_01_DIR_GPIO_Port GPIOB
#define MOTOR_02_DIR_Pin GPIO_PIN_14
#define MOTOR_02_DIR_GPIO_Port GPIOB
#define MOTOR_03_DIR_Pin GPIO_PIN_15
#define MOTOR_03_DIR_GPIO_Port GPIOB
#define HAPTIC_PWM_Pin GPIO_PIN_6
#define HAPTIC_PWM_GPIO_Port GPIOC
#define MOTOR_01_PWM_Pin GPIO_PIN_7
#define MOTOR_01_PWM_GPIO_Port GPIOC
#define MOTOR_02_PWM_Pin GPIO_PIN_8
#define MOTOR_02_PWM_GPIO_Port GPIOC
#define MOTOR_03_PWM_Pin GPIO_PIN_9
#define MOTOR_03_PWM_GPIO_Port GPIOC
#define MOTOR_01_FAULT_Pin GPIO_PIN_8
#define MOTOR_01_FAULT_GPIO_Port GPIOA
#define MOTOR_02_FAULT_Pin GPIO_PIN_9
#define MOTOR_02_FAULT_GPIO_Port GPIOA
#define MOTOR_03_FAULT_Pin GPIO_PIN_10
#define MOTOR_03_FAULT_GPIO_Port GPIOA
#define BTN_Pin GPIO_PIN_15
#define BTN_GPIO_Port GPIOA
#define HAPTIC_EN_Pin GPIO_PIN_12
#define HAPTIC_EN_GPIO_Port GPIOC
#define HAPTIC_FAULT_Pin GPIO_PIN_2
#define HAPTIC_FAULT_GPIO_Port GPIOD
#define MOTOR_02_ENCODER_A_Pin GPIO_PIN_6
#define MOTOR_02_ENCODER_A_GPIO_Port GPIOB
#define MOTOR_02_ENCODER_B_Pin GPIO_PIN_7
#define MOTOR_02_ENCODER_B_GPIO_Port GPIOB
