AleksaHeler/OpenHand/(commit log)

2025-01-23 Made PCB v3, and updated CubeIDE firmware with pinout
    [Control.kicad_sch, ESP32.kicad_sch, MotorControl.kicad_sch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]
2025-01-29 Finalize board v3, prepare CubeIDE config
    [MotorControl.kicad_sch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]
2025-01-31 Update PCB via size, start with code infrastructure idea
    [MotorControl.kicad_sch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]
2025-04-18 Update PCB with larger vias, add board temp sensor
    [MotorControl.kicad_sch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]
